hc5/GC-to-USB/Board/BoardGndPour.png

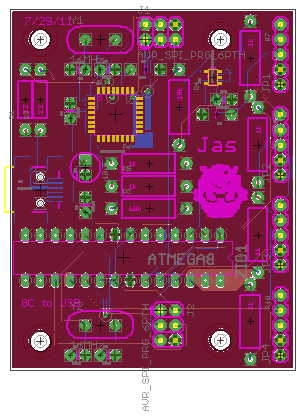
Board/BoardGndPour.png
