hc5/GC-to-USB/Board/BoardPreFactoring.png

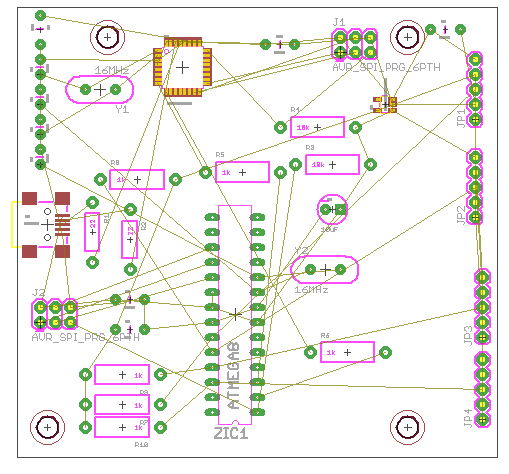
Board/BoardPreFactoring.png
