hc5/GC-to-USB/Board/BoardTracePreFactoring.png

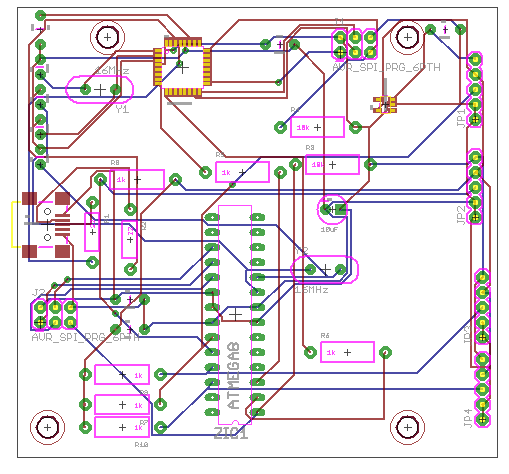
Board/BoardTracePreFactoring.png
