hc5/GC-to-USB/Board/Boardv1_0.png

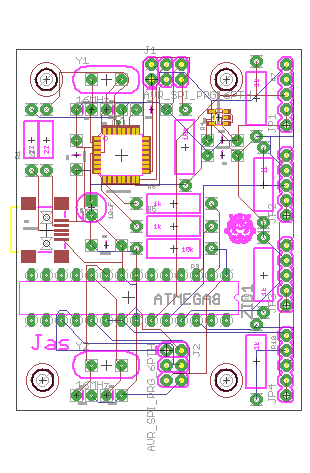
Board/Boardv1_0.png
