hc5/GC-to-USB/Board/Schematicv1_0.png

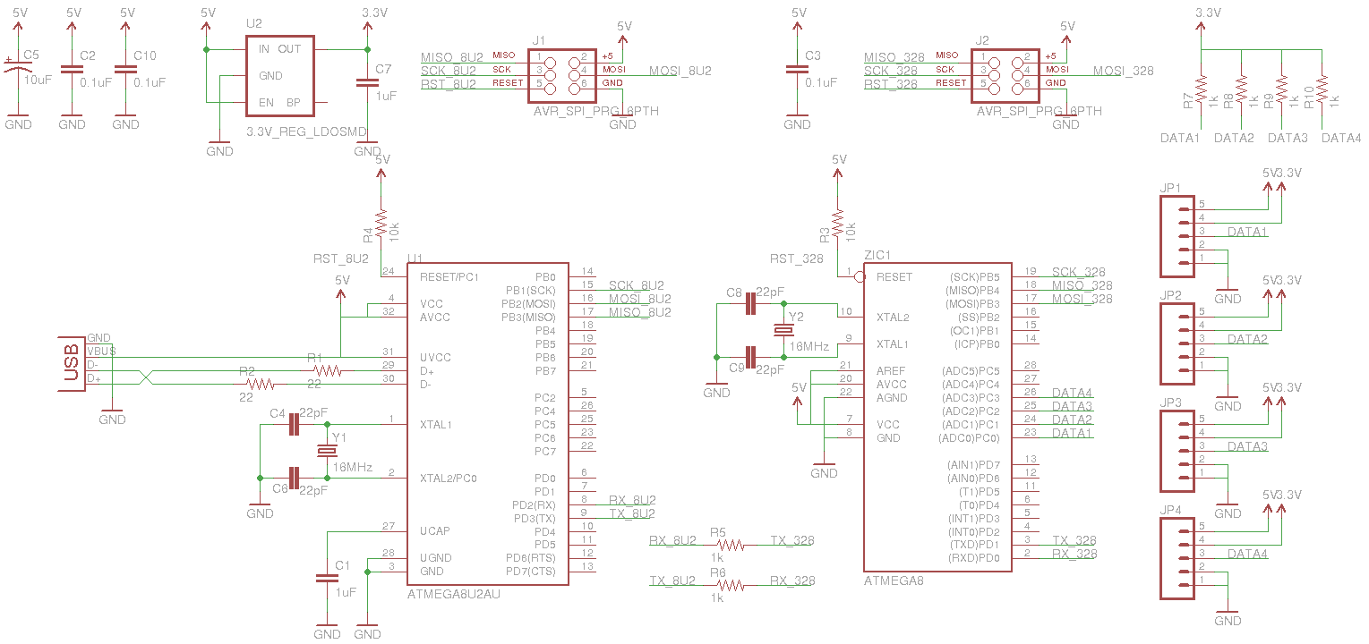
Board/Schematicv1_0.png
