hc5/GC-to-USB/Board/PartsList.png

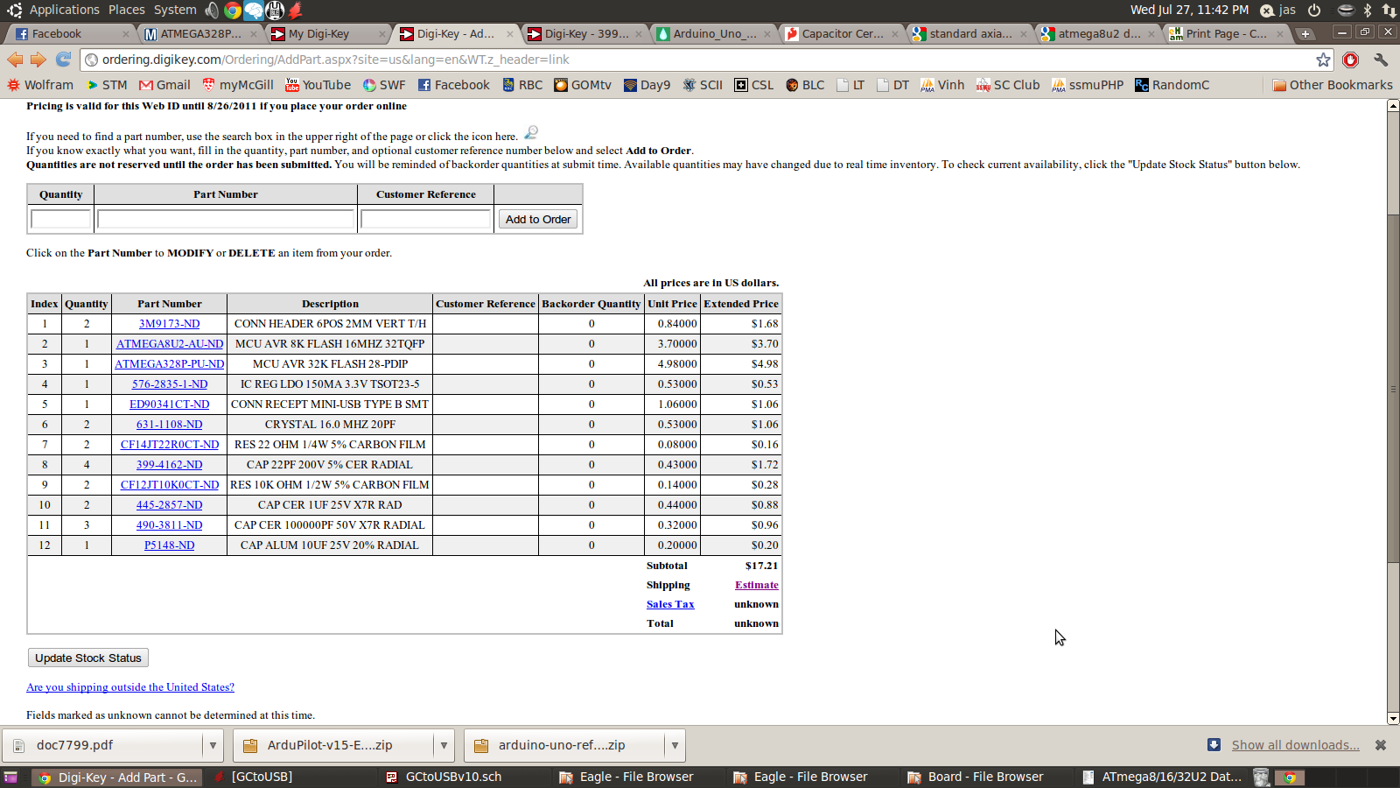
Board/PartsList.png
