hc5/GC-to-USB/Case/PCBCase.SLDASM

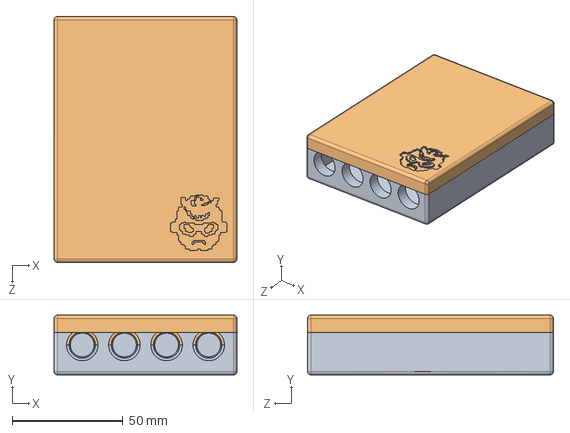
[picture p7: CAD file, 2012-03-18]
Case/PCBCase.SLDASM
82.5 x 27.0 x 111.1 mm
CaseBottom_1_0
CaseTop_1_0
