hc5/GC-to-USB/Case/CaseBottom_1_1.SLDPRT

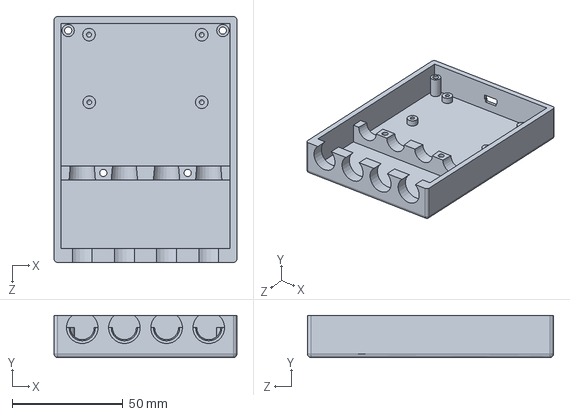
[picture p8: CAD file, 2012-03-18]
Case/CaseBottom_1_1.SLDPRT
82.5 x 19.1 x 111.1 mm
