hc5/GC-to-USB/Case/CaseTop_1_1.SLDPRT

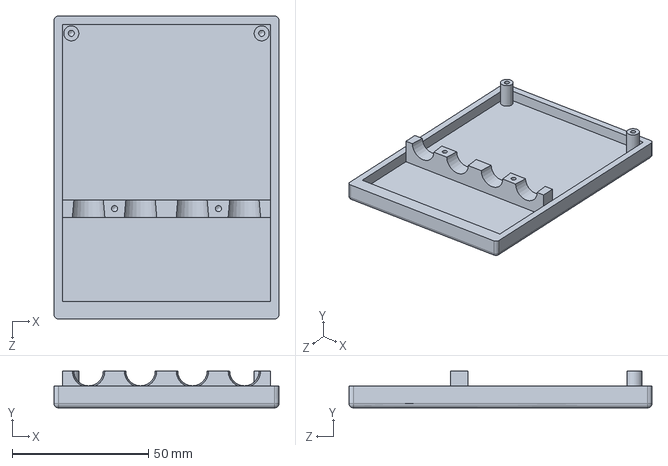
[picture p9: CAD file, 2012-03-18]
Case/CaseTop_1_1.SLDPRT
82.5 x 13.5 x 111.1 mm
