hc5/GC-to-USB/(list of files, cad)

Other CAD files:
Case/GCtoUSBCase.SLDASM
