hc5/GC-to-USB/Board/GCtoUSBv1_1.pdf

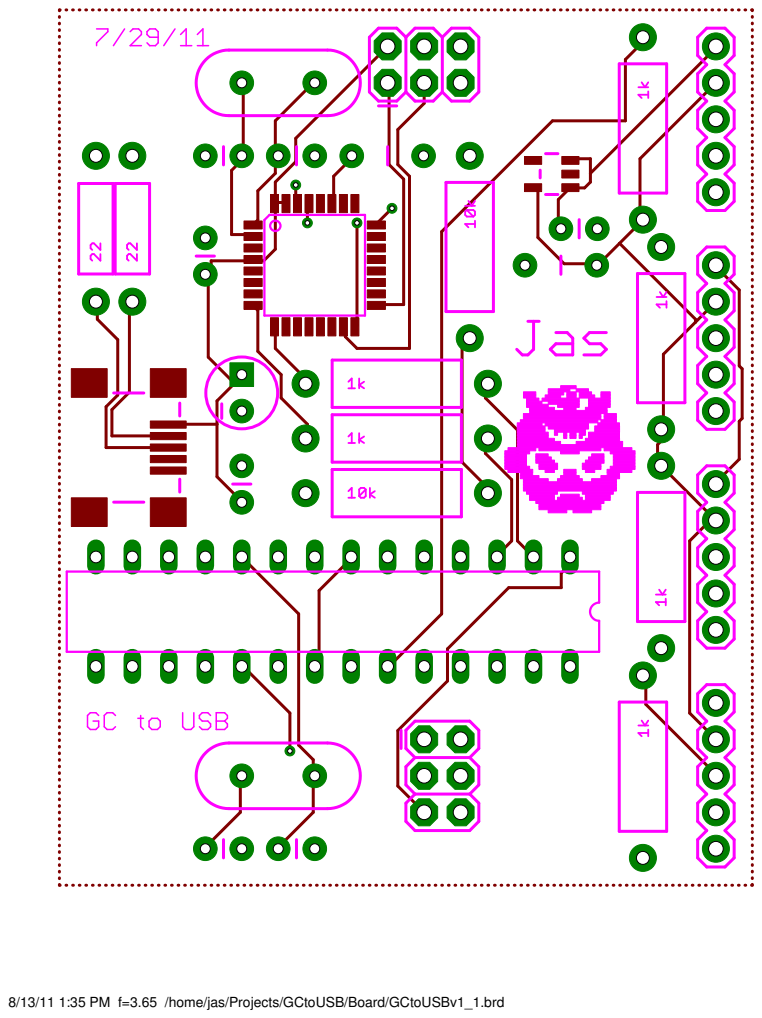
[picture p10: page 1]

8/13/11 1:35 PM f=3.65 /home/jas/Projects/GCtoUSB/Board/GCtoUSBv1_1.brd
