hc5/GC-to-USB/Firmware/atmega8u2/FourControllers_v1_1/GC-Gamepad.c

/*
             LUFA Library
     Copyright (C) Dean Camera, 2010.
              
  dean [at] fourwalledcubicle [dot] com
      www.fourwalledcubicle.com
*/

/*
  Copyright 2010  Dean Camera (dean [at] fourwalledcubicle [dot] com)

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
  The author disclaim all warranties with regard to this
  software, including all implied warranties of merchantability
  and fitness.  In no event shall the author be liable for any
  special, indirect or consequential damages or any damages
  whatsoever resulting from loss of use, data or profits, whether
  in an action of contract, negligence or other tortious action,
  arising out of or in connection with the use or performance of
  this software.
*/

/*-
 * Copyright (c) 2011 Darran Hunt (darran [at] hunt dot net dot nz)
 * All rights reserved.
 *
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
 * THIS SOFTWARE IS PROVIDED ``AS IS'' AND ANY EXPRESS OR IMPLIED WARRANTIES,
 * INCLUDING, BUT NOT LIMITED TO, THE IMPLIED WARRANTIES OF MERCHANTABILITY
 * AND FITNESS FOR A PARTICULAR PURPOSE ARE DISCLAIMED.  IN NO EVENT SHALL
 * THE CONTRIBUTORS BE LIABLE FOR ANY DIRECT, INDIRECT, INCIDENTAL, SPECIAL,
 * EXEMPLARY, OR CONSEQUENTIAL DAMAGES (INCLUDING, BUT NOT LIMITED TO,
 * PROCUREMENT OF SUBSTITUTE GOODS OR SERVICES; LOSS OF USE, DATA, OR PROFITS;
 * OR BUSINESS INTERRUPTION) HOWEVER CAUSED AND ON ANY THEORY OF LIABILITY,
 * WHETHER IN CONTRACT, STRICT LIABILITY, OR TORT (INCLUDING NEGLIGENCE OR
 * OTHERWISE) ARISING IN ANY WAY OUT OF THE USE OF THIS SOFTWARE, EVEN IF
 * ADVISED OF THE POSSIBILITY OF SUCH DAMAGE.
 */

/** \file
 *
 *  Main source file for the Arduino-mouse project. This file contains the main tasks of
 *  the project and is responsible for the initial application hardware configuration.
 */

#include "GC-Gamepad.h"

/** Buffer to hold the previously generated HID report, for comparison purposes inside the HID class driver. */
uint8_t PrevJoystickHIDReportBuffer[sizeof(USB_JoystickReport_Data_t)];

/** LUFA HID Class driver interface configuration and state information. This structure is
 *  passed to all HID Class driver functions, so that multiple instances of the same class
 *  within a device can be differentiated from one another.
 */
USB_ClassInfo_HID_Device_t Joystick_HID_Interface = {
    .Config = {
	.InterfaceNumber              = 0,

	.ReportINEndpointNumber       = JOYSTICK_EPNUM,
	.ReportINEndpointSize         = JOYSTICK_EPSIZE,
	.ReportINEndpointDoubleBank   = false,

	.PrevReportINBuffer           = PrevJoystickHIDReportBuffer,
	.PrevReportINBufferSize       = sizeof(PrevJoystickHIDReportBuffer),
    },
};


/** Main program entry point. This routine contains the overall program flow, including initial
 *  setup of all components and the main program loop.
 */

/** Circular buffer to hold data from the serial port before it is sent to the host. */
RingBuffer_t USARTtoUSB_Buffer;
uint8_t      BufferData[72]; //Allows for 8 controller reports. 9 * 8

/** Main program entry point. This routine contains the overall program flow, including initial
 *  setup of all components and the main program loop.
 */
int main(void)
{
    SetupHardware();

    RingBuffer_InitBuffer(&USARTtoUSB_Buffer, BufferData, sizeof(BufferData));

    sei();

    for (;;) {
	HID_Device_USBTask(&Joystick_HID_Interface);
	USB_USBTask();
    }
}

/** Configures the board hardware and chip peripherals for the demo's functionality. */
void SetupHardware(void)
{
    /* Disable watchdog if enabled by bootloader/fuses */
    MCUSR &= ~(1 << WDRF);
    wdt_disable();

    /* Hardware Initialization */
    Serial_Init(115200, true);
    USB_Init();

    UCSR1B = ((1 << RXCIE1) | (1 << TXEN1) | (1 << RXEN1));
}

/** Event handler for the library USB Configuration Changed event. */
void EVENT_USB_Device_ConfigurationChanged(void)
{
    HID_Device_ConfigureEndpoints(&Joystick_HID_Interface);

    USB_Device_EnableSOFEvents();
}

/** Event handler for the library USB Unhandled Control Request event. */
void EVENT_USB_Device_UnhandledControlRequest(void)
{
    HID_Device_ProcessControlRequest(&Joystick_HID_Interface);
}

/** Event handler for the USB device Start Of Frame event. */
void EVENT_USB_Device_StartOfFrame(void)
{
    HID_Device_MillisecondElapsed(&Joystick_HID_Interface);
}

/** HID class driver callback function for the creation of HID reports to the host.
 *
 *  \param[in]     HIDInterfaceInfo  Pointer to the HID class interface configuration structure being referenced
 *  \param[in,out] ReportID    Report ID requested by the host if non-zero, otherwise callback should set to the generated report ID
 *  \param[in]     ReportType  Type of the report to create, either REPORT_ITEM_TYPE_In or REPORT_ITEM_TYPE_Feature
 *  \param[out]    ReportData  Pointer to a buffer where the created report should be stored
 *  \param[out]    ReportSize  Number of bytes written in the report (or zero if no report is to be sent
 *
 *  \return Boolean true to force the sending of the report, false to let the library determine if it needs to be sent
 */
bool CALLBACK_HID_Device_CreateHIDReport(
    USB_ClassInfo_HID_Device_t* const HIDInterfaceInfo,
    uint8_t* const ReportID,
    const uint8_t ReportType,
    void* ReportData,
    uint16_t* const ReportSize)
{
   uint8_t* JoystickReport = (uint8_t*)ReportData;

   if (RingBuffer_GetCount(&USARTtoUSB_Buffer) < (sizeof(USB_JoystickReport_Data_t) + sizeof(uint8_t)))
       return false;

   *ReportID   = RingBuffer_Remove(&USARTtoUSB_Buffer);
   *ReportSize = sizeof(USB_JoystickReport_Data_t);

   for (uint8_t i = 0; i < sizeof(USB_JoystickReport_Data_t); i++)
       JoystickReport[i] = RingBuffer_Remove(&USARTtoUSB_Buffer);

   return false;
}

/** HID class driver callback function for the processing of HID reports from the host.
 *
 *  \param[in] HIDInterfaceInfo  Pointer to the HID class interface configuration structure being referenced
 *  \param[in] ReportID    Report ID of the received report from the host
 *  \param[in] ReportType  The type of report that the host has sent, either REPORT_ITEM_TYPE_Out or REPORT_ITEM_TYPE_Feature
 *  \param[in] ReportData  Pointer to a buffer where the created report has been stored
 *  \param[in] ReportSize  Size in bytes of the received HID report
 */
void CALLBACK_HID_Device_ProcessHIDReport(USB_ClassInfo_HID_Device_t* const HIDInterfaceInfo,
                                          const uint8_t ReportID,
                                          const uint8_t ReportType,
                                          const void* ReportData,
                                          const uint16_t ReportSize)
{
    /* Not used but must be present */
}

/** ISR to manage the reception of data from the serial port, placing received bytes into a circular buffer
 *  for later transmission to the host.
 */
ISR(USART1_RX_vect, ISR_BLOCK)
{
    uint8_t ReceivedByte = UDR1;

    if ((USB_DeviceState == DEVICE_STATE_Configured) &&
	    !RingBuffer_IsFull(&USARTtoUSB_Buffer)) {
	RingBuffer_Insert(&USARTtoUSB_Buffer, ReceivedByte);
    }
}
