hc5/GC-to-USB/Firmware/atmega8u2/FourControllers_v1_1/Descriptors.c

/*
             LUFA Library
     Copyright (C) Dean Camera, 2010.
              
  dean [at] fourwalledcubicle [dot] com
      www.fourwalledcubicle.com
*/

/*
  Copyright 2010  Dean Camera (dean [at] fourwalledcubicle [dot] com)

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
  The author disclaim all warranties with regard to this
  software, including all implied warranties of merchantability
  and fitness.  In no event shall the author be liable for any
  special, indirect or consequential damages or any damages
  whatsoever resulting from loss of use, data or profits, whether
  in an action of contract, negligence or other tortious action,
  arising out of or in connection with the use or performance of
  this software.
*/

/** \file
 *
 *  USB Device Descriptors, for library use when in USB device mode. Descriptors are special 
 *  computer-readable structures which the host requests upon device enumeration, to determine
 *  the device's capabilities and functions.  
 */

#include "Descriptors.h"

/** HID class report descriptor. This is a special descriptor constructed with values from the
 *  USBIF HID class specification to describe the reports and capabilities of the HID device. This
 *  descriptor is parsed by the host and its contents used to determine what data (and in what encoding)
 *  the device will send, and what it may be sent back from the host. Refer to the HID specification for
 *  more details on HID report descriptors.
 */
USB_Descriptor_HIDReport_Datatype_t PROGMEM JoystickReport[] =
{		
	0x05, 0x01,				// USAGE_PAGE (Generic Desktop)
	0x09, 0x05,				// USAGE (Game Pad)
	0xa1, 0x01,				// COLLECTION (Application)
	0xa1, 0x00,				//    COLLECTION (Physical)
	0x85, 0x01,             		//    	  REPORT_ID (1)
	0x05, 0x09,				//        USAGE_PAGE (Button)
	0x19, 0x01,				//        USAGE_MINIMUM (Button 1)
	0x29, 0x05,				//        USAGE_MAXIMUM (Button 5)
	0x15, 0x00,				//        LOGICAL_MINIMUM (0)
	0x25, 0x01,				//        LOGICAL_MAXIMUM (1)
	0x95, 0x05,				//        REPORT_COUNT (5)
	0x75, 0x01,				//        REPORT_SIZE (1)
	0x81, 0x02,				//        INPUT (Data,Var,Abs)
	0x95, 0x01,                    		//     	  REPORT_COUNT (1)
	0x75, 0x03,                    		//     	  REPORT_SIZE (3)
	0x81, 0x03,                    		//     	  INPUT (Cnst,Var,Abs)
	0x05, 0x09,				//        USAGE_PAGE (Button)
	0x19, 0x06,				//        USAGE_MINIMUM (Button 6)
	0x29, 0x0C,				//        USAGE_MAXIMUM (Button 12)
	0x15, 0x00,				//        LOGICAL_MINIMUM (0)
	0x25, 0x01,				//        LOGICAL_MAXIMUM (1)
	0x95, 0x07,				//        REPORT_COUNT (7)
	0x75, 0x01,				//        REPORT_SIZE (1)
	0x81, 0x02,				//        INPUT (Data,Var,Abs)
	0x95, 0x01,                    		//     	  REPORT_COUNT (1)
	0x75, 0x01,                    		//     	  REPORT_SIZE (1)
	0x81, 0x03,                    		//     	  INPUT (Cnst,Var,Abs)
	0x05, 0x01,				//        USAGE_PAGE (Generic Desktop)
	0x09, 0x30,				//        USAGE (X)
	0x09, 0x31,				//        USAGE (Y)
	0x09, 0x33,				//        USAGE (Rx)
	0x09, 0x34,				//        USAGE (Ry)
	0x09, 0x35,				//	  USAGE (Rz)	
	0x09, 0x36,				//	  USAGE (Slider)
	0x15, 0x00,				//        LOGICAL_MINIMUM (0)
	0x26, 0xFF, 0x00,			//        LOGICAL_MAXIMUM (255)
	0x75, 0x08,				//        REPORT_SIZE (8)
	0x95, 0x06,				//        REPORT_COUNT (6)
	0x81, 0x02,				//        INPUT (Data,Var,Abs)
	0xc0,					//    END COLLECTION
	0xc0,					// END COLLECTION

	0x05, 0x01,				// USAGE_PAGE (Generic Desktop)
	0x09, 0x05,				// USAGE (Game Pad)
	0xa1, 0x01,				// COLLECTION (Application)
	0xa1, 0x00,				//    COLLECTION (Physical)
	0x85, 0x02,             		//    	  REPORT_ID (2)
	0x05, 0x09,				//        USAGE_PAGE (Button)
	0x19, 0x01,				//        USAGE_MINIMUM (Button 1)
	0x29, 0x05,				//        USAGE_MAXIMUM (Button 5)
	0x15, 0x00,				//        LOGICAL_MINIMUM (0)
	0x25, 0x01,				//        LOGICAL_MAXIMUM (1)
	0x95, 0x05,				//        REPORT_COUNT (5)
	0x75, 0x01,				//        REPORT_SIZE (1)
	0x81, 0x02,				//        INPUT (Data,Var,Abs)
	0x95, 0x01,                    		//     	  REPORT_COUNT (1)
	0x75, 0x03,                    		//     	  REPORT_SIZE (3)
	0x81, 0x03,                    		//     	  INPUT (Cnst,Var,Abs)
	0x05, 0x09,				//        USAGE_PAGE (Button)
	0x19, 0x06,				//        USAGE_MINIMUM (Button 6)
	0x29, 0x0C,				//        USAGE_MAXIMUM (Button 12)
	0x15, 0x00,				//        LOGICAL_MINIMUM (0)
	0x25, 0x01,				//        LOGICAL_MAXIMUM (1)
	0x95, 0x07,				//        REPORT_COUNT (7)
	0x75, 0x01,				//        REPORT_SIZE (1)
	0x81, 0x02,				//        INPUT (Data,Var,Abs)
	0x95, 0x01,                    		//     	  REPORT_COUNT (1)
	0x75, 0x01,                    		//     	  REPORT_SIZE (1)
	0x81, 0x03,                    		//     	  INPUT (Cnst,Var,Abs)
	0x05, 0x01,				//        USAGE_PAGE (Generic Desktop)
	0x09, 0x30,				//        USAGE (X)
	0x09, 0x31,				//        USAGE (Y)
	0x09, 0x33,				//        USAGE (Rx)
	0x09, 0x34,				//        USAGE (Ry)
	0x09, 0x35,				//	  USAGE (Rz)	
	0x09, 0x36,				//	  USAGE (Slider)
	0x15, 0x00,				//        LOGICAL_MINIMUM (0)
	0x26, 0xFF, 0x00,			//        LOGICAL_MAXIMUM (255)
	0x75, 0x08,				//        REPORT_SIZE (8)
	0x95, 0x06,				//        REPORT_COUNT (6)
	0x81, 0x02,				//        INPUT (Data,Var,Abs)
	0xc0,					//    END COLLECTION
	0xc0,					// END COLLECTION

	0x05, 0x01,				// USAGE_PAGE (Generic Desktop)
	0x09, 0x05,				// USAGE (Game Pad)
	0xa1, 0x01,				// COLLECTION (Application)
	0xa1, 0x00,				//    COLLECTION (Physical)
	0x85, 0x03,             		//    	  REPORT_ID (3)
	0x05, 0x09,				//        USAGE_PAGE (Button)
	0x19, 0x01,				//        USAGE_MINIMUM (Button 1)
	0x29, 0x05,				//        USAGE_MAXIMUM (Button 5)
	0x15, 0x00,				//        LOGICAL_MINIMUM (0)
	0x25, 0x01,				//        LOGICAL_MAXIMUM (1)
	0x95, 0x05,				//        REPORT_COUNT (5)
	0x75, 0x01,				//        REPORT_SIZE (1)
	0x81, 0x02,				//        INPUT (Data,Var,Abs)
	0x95, 0x01,                    		//     	  REPORT_COUNT (1)
	0x75, 0x03,                    		//     	  REPORT_SIZE (3)
	0x81, 0x03,                    		//     	  INPUT (Cnst,Var,Abs)
	0x05, 0x09,				//        USAGE_PAGE (Button)
	0x19, 0x06,				//        USAGE_MINIMUM (Button 6)
	0x29, 0x0C,				//        USAGE_MAXIMUM (Button 12)
	0x15, 0x00,				//        LOGICAL_MINIMUM (0)
	0x25, 0x01,				//        LOGICAL_MAXIMUM (1)
	0x95, 0x07,				//        REPORT_COUNT (7)
	0x75, 0x01,				//        REPORT_SIZE (1)
	0x81, 0x02,				//        INPUT (Data,Var,Abs)
	0x95, 0x01,                    		//     	  REPORT_COUNT (1)
	0x75, 0x01,                    		//     	  REPORT_SIZE (1)
	0x81, 0x03,                    		//     	  INPUT (Cnst,Var,Abs)
	0x05, 0x01,				//        USAGE_PAGE (Generic Desktop)
	0x09, 0x30,				//        USAGE (X)
	0x09, 0x31,				//        USAGE (Y)
	0x09, 0x33,				//        USAGE (Rx)
	0x09, 0x34,				//        USAGE (Ry)
	0x09, 0x35,				//	  USAGE (Rz)	
	0x09, 0x36,				//	  USAGE (Slider)
	0x15, 0x00,				//        LOGICAL_MINIMUM (0)
	0x26, 0xFF, 0x00,			//        LOGICAL_MAXIMUM (255)
	0x75, 0x08,				//        REPORT_SIZE (8)
	0x95, 0x06,				//        REPORT_COUNT (6)
	0x81, 0x02,				//        INPUT (Data,Var,Abs)
	0xc0,					//    END COLLECTION
	0xc0,					// END COLLECTION

	0x05, 0x01,				// USAGE_PAGE (Generic Desktop)
	0x09, 0x05,				// USAGE (Game Pad)
	0xa1, 0x01,				// COLLECTION (Application)
	0xa1, 0x00,				//    COLLECTION (Physical)
	0x85, 0x04,             		//    	  REPORT_ID (4)
	0x05, 0x09,				//        USAGE_PAGE (Button)
	0x19, 0x01,				//        USAGE_MINIMUM (Button 1)
	0x29, 0x05,				//        USAGE_MAXIMUM (Button 5)
	0x15, 0x00,				//        LOGICAL_MINIMUM (0)
	0x25, 0x01,				//        LOGICAL_MAXIMUM (1)
	0x95, 0x05,				//        REPORT_COUNT (5)
	0x75, 0x01,				//        REPORT_SIZE (1)
	0x81, 0x02,				//        INPUT (Data,Var,Abs)
	0x95, 0x01,                    		//     	  REPORT_COUNT (1)
	0x75, 0x03,                    		//     	  REPORT_SIZE (3)
	0x81, 0x03,                    		//     	  INPUT (Cnst,Var,Abs)
	0x05, 0x09,				//        USAGE_PAGE (Button)
	0x19, 0x06,				//        USAGE_MINIMUM (Button 6)
	0x29, 0x0C,				//        USAGE_MAXIMUM (Button 12)
	0x15, 0x00,				//        LOGICAL_MINIMUM (0)
	0x25, 0x01,				//        LOGICAL_MAXIMUM (1)
	0x95, 0x07,				//        REPORT_COUNT (7)
	0x75, 0x01,				//        REPORT_SIZE (1)
	0x81, 0x02,				//        INPUT (Data,Var,Abs)
	0x95, 0x01,                    		//     	  REPORT_COUNT (1)
	0x75, 0x01,                    		//     	  REPORT_SIZE (1)
	0x81, 0x03,                    		//     	  INPUT (Cnst,Var,Abs)
	0x05, 0x01,				//        USAGE_PAGE (Generic Desktop)
	0x09, 0x30,				//        USAGE (X)
	0x09, 0x31,				//        USAGE (Y)
	0x09, 0x33,				//        USAGE (Rx)
	0x09, 0x34,				//        USAGE (Ry)
	0x09, 0x35,				//	  USAGE (Rz)	
	0x09, 0x36,				//	  USAGE (Slider)
	0x15, 0x00,				//        LOGICAL_MINIMUM (0)
	0x26, 0xFF, 0x00,			//        LOGICAL_MAXIMUM (255)
	0x75, 0x08,				//        REPORT_SIZE (8)
	0x95, 0x06,				//        REPORT_COUNT (6)
	0x81, 0x02,				//        INPUT (Data,Var,Abs)
	0xc0,					//    END COLLECTION
	0xc0					// END COLLECTION
};

/** Device descriptor structure. This descriptor, located in FLASH memory, describes the overall
 *  device characteristics, including the supported USB version, control endpoint size and the
 *  number of device configurations. The descriptor is read out by the USB host when the enumeration
 *  process begins.
 */
USB_Descriptor_Device_t PROGMEM DeviceDescriptor =
{
	.Header                 = {.Size = sizeof(USB_Descriptor_Device_t), .Type = DTYPE_Device},
		
	.USBSpecification       = VERSION_BCD(01.10),
	.Class                  = 0x00,
	.SubClass               = 0x00,
	.Protocol               = 0x00,
	
	.Endpoint0Size          = FIXED_CONTROL_ENDPOINT_SIZE,
		
	.VendorID               = 0x03EB,
	.ProductID              = 0x2043,
	.ReleaseNumber          = 0x0000,
		
	.ManufacturerStrIndex   = 0x01,
	.ProductStrIndex        = 0x02,
	.SerialNumStrIndex      = NO_DESCRIPTOR,
		
	.NumberOfConfigurations = FIXED_NUM_CONFIGURATIONS
};

/** Configuration descriptor structure. This descriptor, located in FLASH memory, describes the usage
 *  of the device in one of its supported configurations, including information about any device interfaces
 *  and endpoints. The descriptor is read out by the USB host during the enumeration process when selecting
 *  a configuration so that the host may correctly communicate with the USB device.
 */
USB_Descriptor_Configuration_t PROGMEM ConfigurationDescriptor =
{
	.Config = 
		{
			.Header                 = {.Size = sizeof(USB_Descriptor_Configuration_Header_t), .Type = DTYPE_Configuration},

			.TotalConfigurationSize = sizeof(USB_Descriptor_Configuration_t),
			.TotalInterfaces        = 1,
				
			.ConfigurationNumber    = 1,
			.ConfigurationStrIndex  = NO_DESCRIPTOR,
				
			.ConfigAttributes       = USB_CONFIG_ATTR_BUSPOWERED,
			
			.MaxPowerConsumption    = USB_CONFIG_POWER_MA(100)
		},
		
	.HID_Interface = 
		{
			.Header                 = {.Size = sizeof(USB_Descriptor_Interface_t), .Type = DTYPE_Interface},

			.InterfaceNumber        = 0x00,
			.AlternateSetting       = 0x00,
			
			.TotalEndpoints         = 1,
				
			.Class                  = 0x03,
			.SubClass               = 0x00,
			.Protocol               = 0x00,
				
			.InterfaceStrIndex      = NO_DESCRIPTOR
		},

	.HID_JoystickHID = 
		{
			.Header                 = {.Size = sizeof(USB_HID_Descriptor_HID_t), .Type = HID_DTYPE_HID},
			
			.HIDSpec                = VERSION_BCD(01.11),
			.CountryCode            = 0x00,






			.TotalReportDescriptors = 1,
			.HIDReportType          = HID_DTYPE_Report,
			.HIDReportLength        = sizeof(JoystickReport)
		},

	.HID_ReportINEndpoint = 
		{
			.Header                 = {.Size = sizeof(USB_Descriptor_Endpoint_t), .Type = DTYPE_Endpoint},
			
			.EndpointAddress        = (ENDPOINT_DESCRIPTOR_DIR_IN | JOYSTICK_EPNUM),
			.Attributes             = (EP_TYPE_INTERRUPT | ENDPOINT_ATTR_NO_SYNC | ENDPOINT_USAGE_DATA),
			.EndpointSize           = JOYSTICK_EPSIZE,
			.PollingIntervalMS      = 0x01
		}	
};

/** Language descriptor structure. This descriptor, located in FLASH memory, is returned when the host requests
 *  the string descriptor with index 0 (the first index). It is actually an array of 16-bit integers, which indicate
 *  via the language ID table available at USB.org what languages the device supports for its string descriptors.
 */
USB_Descriptor_String_t PROGMEM LanguageString =
{
	.Header                 = {.Size = USB_STRING_LEN(1), .Type = DTYPE_String},
		
	.UnicodeString          = {LANGUAGE_ID_ENG}
};

/** Manufacturer descriptor string. This is a Unicode string containing the manufacturer's details in human readable
 *  form, and is read out upon request by the host when the appropriate string ID is requested, listed in the Device
 *  Descriptor.
 */
USB_Descriptor_String_t PROGMEM ManufacturerString =
{
	.Header                 = {.Size = USB_STRING_LEN(5), .Type = DTYPE_String},
		
	.UnicodeString          = L"Fizzi"
};

/** Product descriptor string. This is a Unicode string containing the product's details in human readable form,
 *  and is read out upon request by the host when the appropriate string ID is requested, listed in the Device
 *  Descriptor.
 */
USB_Descriptor_String_t PROGMEM ProductString =
{
	.Header                 = {.Size = USB_STRING_LEN(17), .Type = DTYPE_String},
		
	.UnicodeString          = L"Fizzi's GC to USB"
};

/** This function is called by the library when in device mode, and must be overridden (see library "USB Descriptors"
 *  documentation) by the application code so that the address and size of a requested descriptor can be given
 *  to the USB library. When the device receives a Get Descriptor request on the control endpoint, this function
 *  is called so that the descriptor details can be passed back and the appropriate descriptor sent back to the
 *  USB host.
 */
uint16_t CALLBACK_USB_GetDescriptor(const uint16_t wValue,
                                    const uint8_t wIndex,
                                    const void** const DescriptorAddress)
{
	const uint8_t  DescriptorType   = (wValue >> 8);
	const uint8_t  DescriptorNumber = (wValue & 0xFF);

	void*    Address = NULL;
	uint16_t Size    = NO_DESCRIPTOR;

	switch (DescriptorType)
	{
		case DTYPE_Device:
			Address = (void*)&DeviceDescriptor;
			Size    = sizeof(USB_Descriptor_Device_t);
			break;
		case DTYPE_Configuration: 
			Address = (void*)&ConfigurationDescriptor;
			Size    = sizeof(USB_Descriptor_Configuration_t);
			break;
		case DTYPE_String: 
			switch (DescriptorNumber)
			{
				case 0x00: 
					Address = (void*)&LanguageString;
					Size    = pgm_read_byte(&LanguageString.Header.Size);
					break;
				case 0x01: 
					Address = (void*)&ManufacturerString;
					Size    = pgm_read_byte(&ManufacturerString.Header.Size);
					break;
				case 0x02: 
					Address = (void*)&ProductString;
					Size    = pgm_read_byte(&ProductString.Header.Size);
					break;
			}
			
			break;
		case HID_DTYPE_HID: 
			Address = (void*)&ConfigurationDescriptor.HID_JoystickHID;
			Size    = sizeof(USB_HID_Descriptor_HID_t);
			break;
		case HID_DTYPE_Report: 
			Address = (void*)&JoystickReport;
			Size    = sizeof(JoystickReport);
			break;
	}
	
	*DescriptorAddress = Address;
	return Size;
}
