hc5/GC-to-USB/(commit log)

2012-03-18 removed unwanted docs and created "Current" working folders for atmega8u2 and atmega328p code
2012-03-18 Added Case solidworks files. Created directory for v1.1 of 8u2 code and v1.2 of 328p code. New version of 8u2 code only specifies 12 total buttons instead of 16 (no more dummy buttons).
    [CaseBottom_1_1.SLDPRT, CaseTop_1_1.SLDPRT, GCtoUSBCase.SLDASM, PCBCase.SLDASM]
2012-03-19 Began work on newest PCB design fixing minor issues in previous iterations
    [GCtoUSB_Current.brd, GCtoUSB_Current.sch]
2012-03-19 Finished placing parts on newest PCB. Packages adjusted to make nearly all through-hole parts.
    [GCtoUSB_Current.brd, GCtoUSB_Current.sch]
